WYVERN2742/Peanut/Hardware/Peanut.kicad_pcb

## KiCad design Hardware/Peanut.kicad_pcb (2024-12-02)

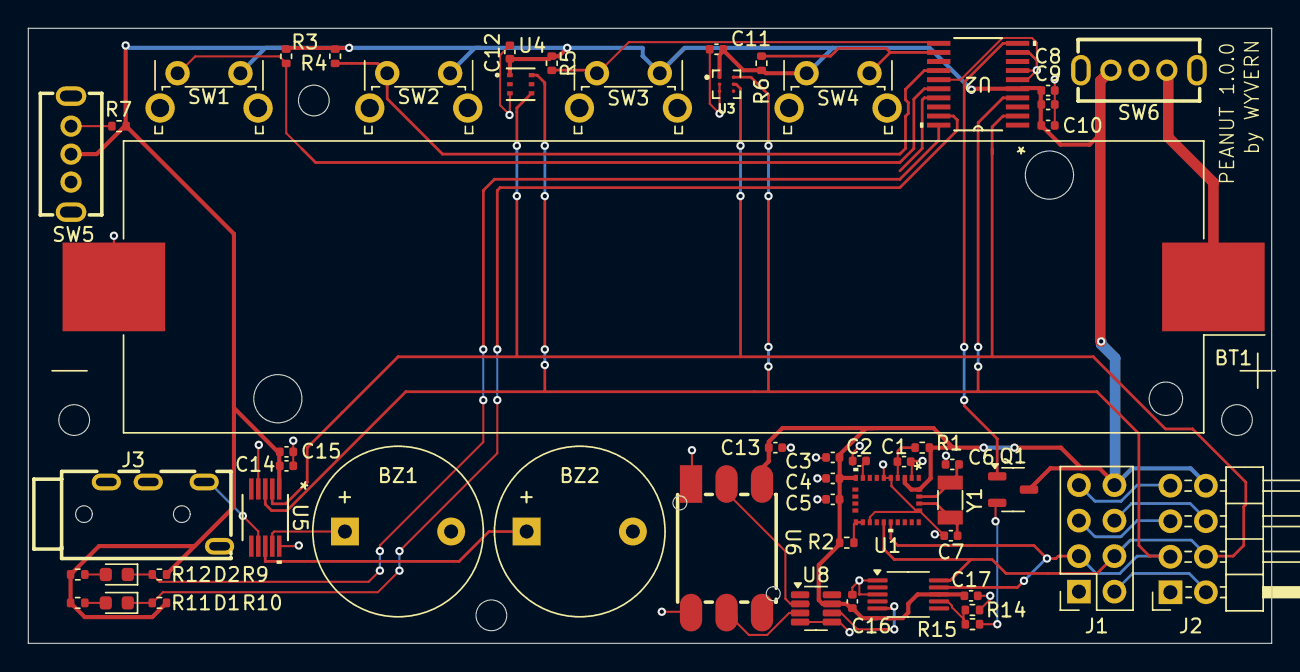
[picture p4: board Peanut.kicad_pcb from above]

Board: 2 copper layers, 89.0 x 44.0 mm, 54 parts (0 on the bottom side), 32 nets.

Parts:
BT1: 3.3V; BatteryHolder_Keystone_1042_1x18650
BZ1, BZ2: Buzzer; Buzzer_12x9.5RM7.6
C1, C3, C4, C5, C8, C9, C10, C11, C13: 1uF; C_0402_1005Metric
C2, C14, C15: 100nF; C_0402_1005Metric
C6, C7: 22pF; C_0402_1005Metric
C12: 1uf; C_0402_1005Metric
C16, C17: 0.1uF; C_0402_1005Metric
D1: RED; LED_0603_1608Metric
D2: YELLOW; LED_0603_1608Metric
J1: BL602 Female JST Connector; PinSocket_2x04_P2.54mm_Vertical
J2: Extension Male JST Connector; PinHeader_2x04_P2.54mm_Horizontal_Flipped
J3: AudioPlug3; AUDIO-TH_PJ-320A-4P-DIP
Q1: Q_NPN_BEC; SOT-23-3
R1: 10k; R_0402_1005Metric
R2, R11, R12: 2.2k; R_0402_1005Metric
R3, R4, R5, R6, R7, R9, R10: 100k; R_0402_1005Metric
R14, R15: R; R_0402_1005Metric
SW1, SW2, SW3, SW4: Push_Button; SW_Tactile_SPST_Angled_PTS645Vx58-2LFS
SW5, SW6: Slide Switch; SW-TH_SK12D07VG4
U1: BNO085; LGA28_5.2X3.8_CEV
U2: PCF8574APWR; PW20
U3: HDC2010YPAR
U4: LTR-303ALS-01; LTR-308ALS-01_LTO
U5: MCP4728T-E/UN; MSOP10_MC_MCH
U6: LWP040-PSGLC-S; SOP-4_L7.0-W7.0-P2.54-LS10.3-TL-CW_LWP040-PSGLC-S
U7: ADS1015IDGSR; VSSOP-10_3x3mm_P0.5mm
U8: INA350ABSIDDFR; TSOT-23-8
Y1: Crystal_32.768kHz; Crystal_SMD_3215-2Pin_3.2x1.5mm

Connections:
+3V3: C3.1, C4.1, C5.1, C8.1, C9.1, C10.1, C11.1, C12.1, C13.1, C14.2, C15.2, C16.1, C17.1, J1.8, J2.8, Q1.3 (C), R1.2, R2.1, R3.1, R4.1, R5.1, R6.1, R7.1, R9.1, R10.1, R11.1, R12.1, SW1.2, SW2.2, SW3.2, SW4.1, SW5.2, SW6.3, U1.3 (VDD), U1.10 (CLKSEL0), U1.28 (VDDIO), U2.5 (VCC), U3.A1 (VDD), U4.1 (VDD), U5.1 (VDD), U6.3 (VIN+), U7.8 (VDD), U8.7 (V+)
/DigitalMuxer/P2: Q1.1 (B), U2.10 (P0)
GND: BT1.2 (-), BZ1.2 (-), BZ2.2 (-), C1.2, C2.1, C3.2, C4.2, C5.2, C6.2, C7.2, C8.2, C9.2, C10.2, C11.2, C12.2, C13.2, C14.1, C15.1, C16.2, C17.2, J1.1, J2.1, J3.S, R15.2, SW5.3, U1.2 (GND), U1.5 (PS1), U1.6 (PS0/WAKE), U1.17 (SA0/H_MOSI), U1.25 (GNDIO), U2.6 (A0), U2.7 (A1), U2.9 (A2), U2.15 (GND), U3.B1 (ADDR), U3.C1 (GND), U4.3 (GND), U5.4 (~LDAC), U5.10 (VSS), U6.1 (GND), U6.6 (GND), U7.1 (ADDR), U7.3 (GND), U8.4 (V-), U8.5 (REF)
unnamed: BT1.1 (+), SW6.1
unnamed: BZ1.1 (+), U5.9 (VOUTD)
unnamed: BZ2.1 (+), U5.8 (VOUTC)
unnamed: D1.2 (A), R11.2
unnamed: D1.1 (K), R10.2, U2.19 (P6)
unnamed: D2.2 (A), R12.2
unnamed: D2.1 (K), R9.2, U2.20 (P7)
unnamed: J1.5, J2.5
unnamed: J1.6, J2.6
unnamed: Q1.2 (E), R14.1
unnamed: C1.1, R1.1, U1.4 (BOOTN)
unnamed: C2.2, U1.9 (CAP)
unnamed: R2.2, U1.15 (S_SCL), U1.16 (S_SDA)
unnamed: C6.1, U1.27 (XIN32), Y1.1
unnamed: C7.1, U1.26 (XOUT32/CLKSEL1), Y1.2
unnamed: R5.2, SW3.1, U2.11 (P1)
unnamed: R6.2, SW4.2, U2.12 (P2)
unnamed: R4.2, SW2.1, U2.14 (P3)
unnamed: R3.2, SW1.1, U2.16 (P4)
unnamed: R7.2, SW5.1, U2.17 (P5)
unnamed: J3.T, U5.7 (VOUTB)
unnamed: U6.2 (VOUT+), U8.2 (-)
unnamed: U6.5 (VOUT-), U8.3 (+)
unnamed: U7.5 (AIN1), U8.6
unnamed: R14.2, R15.1, U7.7 (AIN3)
SCL: J1.4, J2.4, U1.19 (H_SCL/SCK/RX), U2.2 (SCL), U3.B2 (SCL), U4.4 (SCL), U5.2 (SCL), U7.10 (SCL)
SDA: J1.3, J2.3, U1.20 (H_SDA/H_MISO/TX), U2.4 (SDA), U3.A2 (SDA), U4.6 (SDA), U5.3 (SDA), U7.9 (SDA)
UART_RX: J1.7, J2.7
UART_TX: J1.2, J2.2
