WYVERN2742/Peanut/(threads)

Thread 3 (2024-05-05):

Initial Component Selection

WYVERN2742, 2024-05-05:

WYVERN2742, 2024-05-05:
@Brandagot To do sourcing on side-mounted switches
@WYVERN2742 To do sourcing on footprints, and compile datasheets

WYVERN2742, 2024-05-06:
Managed to get a working easyeda -> kicad footprint workflow, main limitations are models for strange parts, and some footprints

WYVERN2742, 2024-05-07:
Got datasheets, footprints, and models for all ✔'s in the component table above.
Just waiting for buzzer, switch and ADC sourcing

Turns out, the pressure sensor works via a [Wheatstone Bridge circuit](https://meritsensor.com/the-wheatstone-bridge/), so it gives `Vout-` and `Vout+`. The differences are too small for direct ADC, so we need to boost them with an opamp.

WYVERN2742, 2024-05-12:
Added 12-bit ADC [ADS1015IDGSR](https://www.lcsc.com/product-detail/Analog-To-Digital-Converters-ADCs_Texas-Instruments-ADS1015IDGSR_C193969.html) and IntAmp [INA350ABSIDDFR](https://www.lcsc.com/product-detail/Instrumentation-OpAmps_Texas-Instruments-INA350ABSIDDFR_C5184576.html) for pressure sensing.

Need to collate I2C addresses, and figure out how to wire battery reading;- we may need another i2c muxer for more outs...

Brandagot, 2024-06-09:
[MCP4728T-E/UN](https://www.lcsc.com/product-detail/Digital-To-Analog-Converters-DACs_Microchip-Tech-MCP4728T-E-UN_C478093.html), play with LDAC / UDAC settings when we get a dev board. Pulling LDAC low will mean immediate output when sending data.

WYVERN2742, 2024-06-09:
~£142.61 without vat
~£171.13 with vat ex delivery

WYVERN2742, 2024-06-09:
Current cost is roughly ~$28.94 / board (or £22.86) without PCB or assembly.

Brandagot, 2024-06-09:
Need a through-hole right angle push button, instead of surface mount.

WYVERN2742, 2024-06-09:
Will bulk-order and manually solder through-hole components, to save on assembly cost

WYVERN2742, 2024-06-17:
Changed from [PCF8574ADWR](https://www.lcsc.com/product-detail/I-O-Expanders_Texas-Instruments-PCF8574ADWR_C2867583.html) -> [PCF8574APWR](https://www.lcsc.com/product-detail/I-O-Expanders_Texas-Instruments-PCF8574APWR_C94361.html) (Package change, it's now smaller, in stock and cheaper!)

WYVERN2742, 2024-06-17:
Just noticed: We forgot about J1 & J2 Connectors for pinenut and extension boards :/

Thread 5 (2024-05-05):

Power Overview, Battery Selecting and Sourcing

WYVERN2742, 2024-05-05:
Create an overview of power consumption.
Should include:
- Draw when Idle
- Draw when max computation
- Draw when transmitting
- Draw when recieving
- Estimated lifetime in all modes

WYVERN2742, 2024-05-06:
Original idea was to use 14500's (AA) LiFePO4 batteries, but their discharge rate didn't meet our criteria (0.2C, of 600mAh is nowhere near enough)

Found out there are good (0.2C @ 1800mAh) 18650's, which aren't that much larger than AA.
https://www.allbatteries.co.uk/lithium-iron-phosphate-battery-ifr18650-lifepo4-3-2v-1-8ah-ft-acl9073b10.html
**These have a budget of 360mAh max draw.**

**Max Draw of BL602 is 310mA at with (11b - 11Mbps @21dBm 99% duty cycle)**

And can use a nice battery charger for them, don't need a custom charge circuit
https://www.amazon.co.uk/dp/B0CB81GV49

Since LiFePO4's are good at trickle charging, they're already used in most solar applications, so making a solar charger shouldn't need to change the battery type.

WYVERN2742, 2024-06-09:
Batteries have been purchased! (#7)

Closed 2024-06-09.

Thread 7 (2024-05-12):

Devkit sourcing

Brandagot, 2024-05-12:

Brandagot, 2024-05-12:
Need to source ADC and opamp if needed.

WYVERN2742, 2024-06-09:
~£142.61 without vat
~£171.13 with vat ex delivery

WYVERN2742, 2024-06-09:
Purchased ACL9073B10 & Charger

Brandagot, 2024-06-14:
Need a new source for the HDC2010 dev board, unable to order correct thing from itbrains

Thread 8 (2024-05-12):

Manufacturer and Assembly Sourcing

WYVERN2742, 2024-05-12:
We're using small SMT parts that are hard to mount by hand, we need to pick the cheapest assembly and PCB manufacturer that supports our parts (or has a known part listing)

| Manufacturer | Country | Part Sourcing | Cost of 5 prototype board inc shipping | Other Comments |
| --- | --- | --- | --- | ---|
| JLCPCB | CN | [LCSC](https://www.lcsc.com/) | -- | Has Colours + Coupons |
| PCBWAY | CN | ??? | -- | Popular + Coupons|
| Seeedstudio | CN | [Open Parts Library](https://www.seeedstudio.com/opl.html) [Digikey](https://www.digikey.co.uk/) | -- | Kicad Integration + Coupons|

WYVERN2742, 2024-05-12:
Waiting for #3 and a very quick PCB sketch for trace/vias and gerbers for price checking

Some require a full BOM for even base assembly cost, will take some time
