WYVERN2742/Peanut/(commit log)

2024-04-10 Add Temperature and Humidity Sensor
    [Peanut.kicad_sch, TempAndHumid.kicad_sch]
2024-04-10 Add bypass cap to humid, and fix add grounding
    [TempAndHumid.kicad_sch]
2024-04-11 Ambient Light Sensor
    [LightSensor.kicad_sch, Peanut.kicad_sch]
2024-05-05 Use tags for nets, apply netgroups, mess around in pcb view
    [DigitalMuxer.kicad_sch, LightSensor.kicad_sch, MotionSensor.kicad_sch, Peanut.kicad_pcb, Peanut.kicad_sch, TempAndHumid.kicad_sch, pressure-and-adc.kicad_sch]
2024-05-06 Update board layout
2024-05-06 Remove kicad backup directory
2024-05-07 Datasheets and footprints for some components
    [ADP5240.STEP, BatteryHolder_Keystone_1042_1x18650.step, DW0016A.stp, HDC2010YPAR.step, LGA28_5_2X3_8_CEV.step, LTR-308ALS-01_LTO.step, MSOP10_MC_MCH.step]
2024-05-07 Import 3D and Footprints for most components
2024-05-07 Use Peanut symbols, fix ERC errors, progress on DAC & Pressure
    [DigitalMuxer.kicad_sch, LightSensor.kicad_sch, MotionSensor.kicad_sch, Peanut.kicad_pcb, Peanut.kicad_sch, TempAndHumid.kicad_sch, dac-and-sound.kicad_sch, pressure-and-adc.kicad_sch]
2024-05-12 Update roadmap - Added board design & specs - Explicit mention of prototype PCB
2024-06-09 Replace 1 LED with battery measurement toggle - We require an additional IO to toggle battery draining for % measurement, however we had no more ports. After a group discussion, one LED was dropped.
    [DigitalMuxer.kicad_sch, Peanut.kicad_sch, pressure-and-adc.kicad_sch]
2024-06-09 Add Battery Monitoring & Use Project Parts Library
    [DigitalMuxer.kicad_sch, LightSensor.kicad_sch, MotionSensor.kicad_sch, Peanut.kicad_sch, TempAndHumid.kicad_sch, dac-and-sound.kicad_sch, pressure-and-adc.kicad_sch]
2024-06-09 Update DAC and ADC on roadmap
2024-07-03 Fully wired board!
    [DigitalMuxer.kicad_sch, LightSensor.kicad_sch, MotionSensor.kicad_sch, Peanut.kicad_pcb, Peanut.kicad_sch, TempAndHumid.kicad_sch, dac-and-sound.kicad_sch, pressure-and-adc.kicad_sch]
2024-11-24 Initial OS architecture, and updated PCB work After a joint planning session, designed and architected OS structure: ``` src/ |- os: Audio, Accelerometer, Humidity, etc |- drivers: I2C interfaces, pe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
    [DigitalMuxer.kicad_sch, LightSensor.kicad_sch, MotionSensor.kicad_sch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]
2024-12-01 PCF8574 Drivers and example now working on the devkit!
2024-12-02 Updates to PCB and ADC Schematics
    - Swapped audio jack to correct pin (4P-DIP)
    - Add LCSC numbers for all components
    - Reroute some sensitive signal traces
    - Add Board rev and author
    - add 4x M2 mounting holes
    - fixup some misc silkscreen, footprints, and component 3d models
    [DigitalMuxer.kicad_sch, LightSensor.kicad_sch, MotionSensor.kicad_sch, Peanut.kicad_pcb, TempAndHumid.kicad_sch, dac-and-sound.kicad_sch, pressure-and-adc.kicad_sch]
2024-12-08 Update sh2.rs
    Reworked the SH-2 module to exclude items relating directly to the BNO.
    Added structs for data passed/received through SH-2, and a little bit of impl. Still a work in progress.
    [sh2.rs]
2024-12-08 Implement Peanut object Implement LED OS drivers No longer pass i2c on construction
    [PCF8574.rs, blinky-i2c.rs, io.rs, lib.rs, peanut.rs]
